fablab-imperia/PesaturaArnie/images/consumo_dati/README.md

I dati fanno riferimento ad un test sul campo svolto nel periodo dal 22 luglio 2019 al 10 settembre 2019

Periodo        |Condizione Funzionamento|Consumo|Costo 
:-------------:|:----------------------:|:-----:|:-------:
1 giorno       | Normale                |14 kB  |~0.002 €
1 giorno       | Allarme                |1.1 MB | ~0.14 €
1 mese         | Normale                |400 kB | 0.05 €
1 anno (stima) | Normale                |5 MB   | 0.60 €

<hr>

<table style="padding: 10px;">
    <tr>
        <th colspan="2">Funzionamento regolare</th>
    </tr>
    <tr>
        <th>Consumo Dati</th>
        <th>Costo</th>
    </tr>
    <tr>
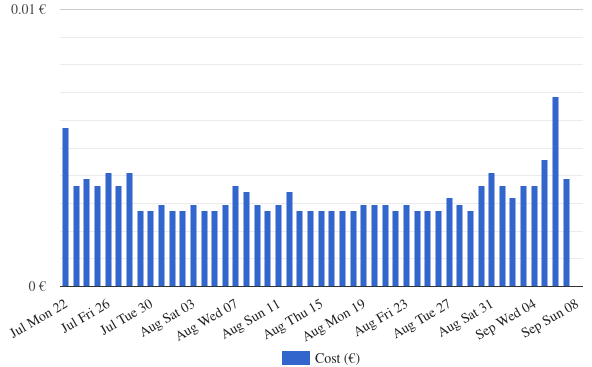
[picture p4: images/consumo_dati/Cost_day_normal.png]
        <td></td>
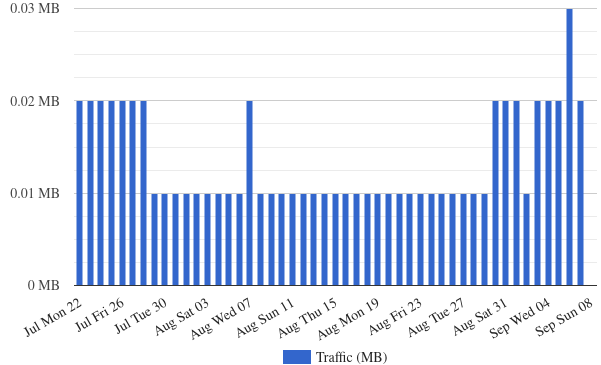
[picture p5: images/consumo_dati/Traffic_day_normal.png]
        <td></td>
    </tr>
    <tr>
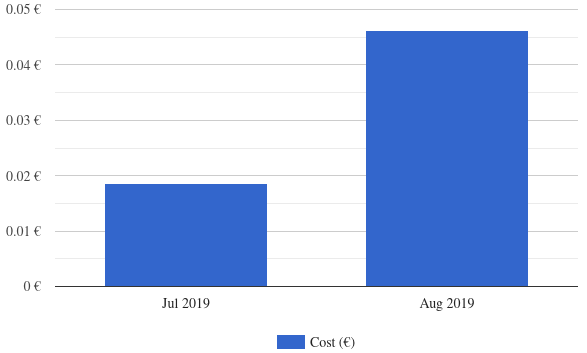
[picture p6: images/consumo_dati/Cost_month_normal.png]
        <td></td>
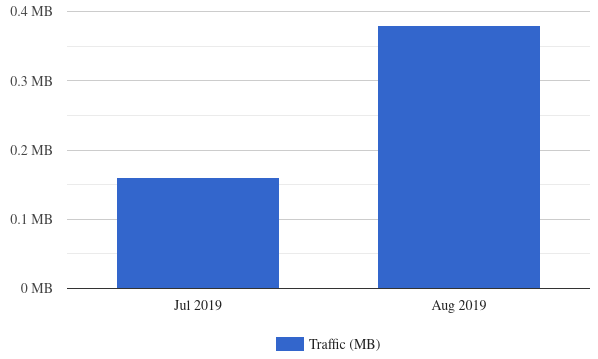
[picture p7: images/consumo_dati/Traffic_month_normal.png]
        <td></td>
    </tr>
</table>

Il sistema ha funzionato in continuo per tutto il mese di Agosto, mentre è stato acceso solo per alcuni giorni a Luglio, per cui il consumo mensile per il mese di luglio non è completo.

<hr>

<table style="padding: 10px;">
    <tr>
        <th colspan="2">Funzionamento in Allarme</th>
    </tr>
    <tr>
        <th>Consumo Dati</th>
        <th>Costo</th>
    </tr>
    <tr>
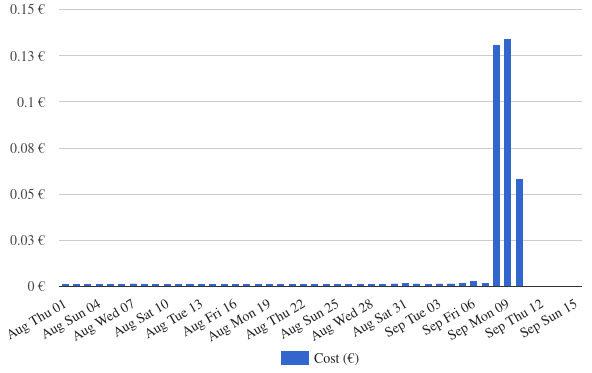
[picture p8: images/consumo_dati/Cost_day_alarm.png]
        <td></td>
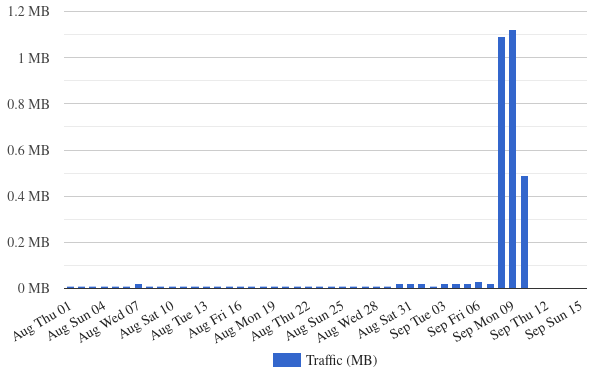
[picture p9: images/consumo_dati/Traffic_day_alarm.png]
        <td></td>
    </tr>
</table>
