fablab-imperia/PesaturaArnie/images/schema_bilancia_api.png

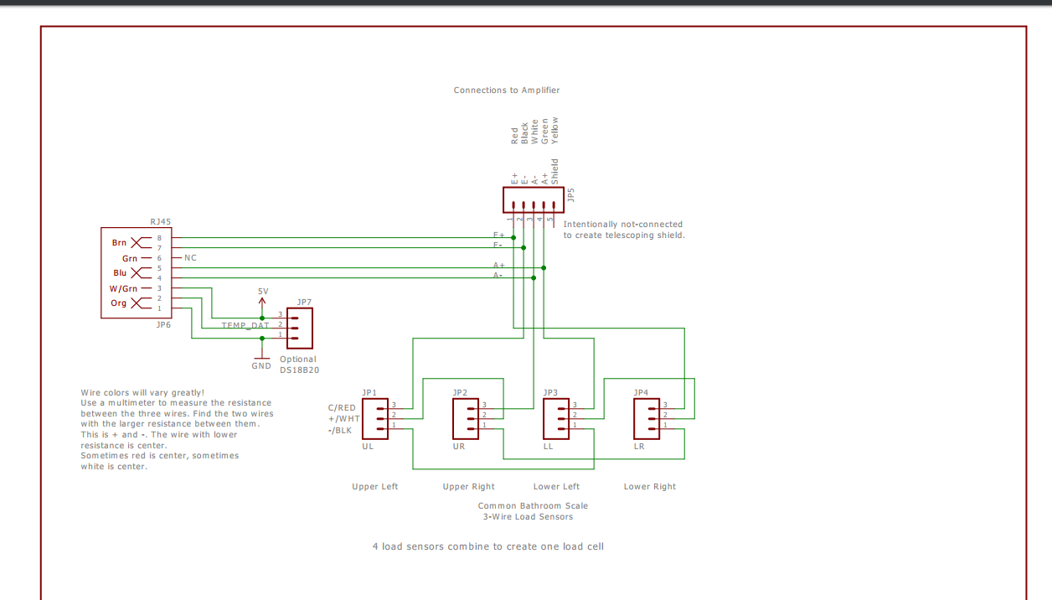
images/schema_bilancia_api.png
