fablab-imperia/PesaturaArnie/(threads)

Thread 1 (2021-04-12):

Richietsa

Tek74, 2021-04-12:
Ciao sono Nicola, non conosco tanto Arduino ne Github....  pero' sto entrando nel mondo
Ora un po' di programmazione l'ho capita ma volevo chiedere un aiuto, ovvero vorrei anch'io fare un sistema per pesature arnia prendendo spunto da Voi. Volevo pero' usare dei pezzi che ho in casa, ovvero arduino uno e su questo mettere la seguente scheda Ttgo t-call v1.3 esp32 (che costa poco) e mettere anche sensore temperatura e umidita' AM2301...
E' fattibile applicare la scheda gsm ttgo su arduino uno? nel caso mi daresti qualche aiuto sulle librerie e programmazione?

Ringrazio e scusa il disturbo

Ciao
Nicola

ssemeria, 2021-04-14:
Ciao Nicola.
Il codice è stato scritto per Arduino MKR, quindi tutta la parte di invio dei dati deve essere modificata usando una libreria con cui la scheda che suggerisci è compatibile (ad esempio https://github.com/vshymanskyy/TinyGSM ). La Ttgo t-call è interessante (avremmo sicuramente usato quella, se lo avessimo saputo). Sarebbe interessante creare una nuova versione del progetto basata sulla scheda che suggerisci in questo momento non siamo però in grado di seguirne gli sviluppi. Ti aggiorniamo in caso avviassimo un progetto nuovo, per il momento puoi pensare di forkare il nostro repository e creare un tuo progetto se vuoi.

Tek74, 2021-04-20:
Grazie veramente... sono neofita dunque necessito di parecchie istruzioni sia su arduino che sull'uso di github.... comunque sto prendendo spunto dai vostri file e per adesso sono riuscito a far leggere il sensore temperatura e umidità Am2301 con la scheda TTGO,  sto collegando anche hx711 e devo testare lo sketch che per ora non mi da errori
Poi dovrò unirli ... è se non sei esperto come me fai veramente fatica.... capisco anche che però sono partito con un progetto un po complesso ma pian piano si fa dai.... mai mollare

Ciao
Nicola

Closed 2021-04-14.

Thread 2 (2021-04-17):

Arnia Tek Pesatura arnia 2.0

Tek74, 2021-04-17:
Pesatura Arnie

Scopo di questo progetto è la realizzazione di un semplice sistema per la pesatura e il monitoraggio di Arnie. Il sistema controlla il peso di un'arnia mediante bilancia a celle di carico, umidità e temperatura e consente un monitoraggio continuo appoggiandosi ad una piattaforma Web e avvisa mediante notifica in caso di anomalia (peso troppo basso, batteria al minimo). Viene usata una nuova scheda TTGO t-call v1.4 e ulteriore sensore di temperatura tipo AM2301.

federicobriata, 2021-05-25:
ciao @Tek74 , vedo che segui il nostro fork di hiveeyes
https://github.com/federicobriata/Bilancia-per-alveari
che praticamente fa quello che ti serve.. che idea avevi in mente per Arnia Tek?

ssemeria, 2021-05-26:
Chiedo scusa, ma questo non è un forum di discussione. Se non avete segnalazioni relative a questo repository Github, vi chiedo la cortesia di continuare la conversazione tra di voi utilizzando altri canali più appropriati.

Tek74, 2021-05-26:
Si scusa ssemeria non conosco github...non capisco come si usa... se riuscite cancellate pure la mia parte... Grazie

ssemeria, 2021-05-26:
Nessun problema. L'idea è che scrivi qui se vuoi segnalare problemi nel codice del nostro progetto su cui vuoi lavorare o vuoi che noi lavoriamo. Questo progetto è un hobby quindi ci dedichiamo davvero poco tempo.

federicobriata, 2021-05-26:
@ssemeria pure per me questo è un hobby e per aiutare alcuni amici nel Acquese e Genovese, io manco ho più le arnie da quando è mancato mio nonno..
Ad ogni modo per quello che ne sapevo voi due potevate anche conoscervi e questo ticket poteva sembrare una richiesta di nuova features e la mia una offerta di collaborazione, fino ai tuo commento non mi sentivo OT o fuori posto visto che il tema mi pare pressappoco lo stesso.
Se hai anche un link su forum dove poter continuare questa discussione ben venga, io non ne conosco. Grazie

@Tek74 la mia email la trovi sulle commit del mio progetto, il resto su Google. ti lascio anche il telegram: @fedegroovie
Ciao

Closed 2021-05-26.
