fablab-imperia/PesaturaArnie/Batteria.ino

float livello_batteria() {                                                            // Controlla lo stato della batteria...
  float min_batteria = 3.6;                                                           // La tensione massima della batteria
  float max_batteria = 4.2;                                                           // La tensione minima della batteria

  tens = 0;                                                                           // Azzero la variabile che userò per mediare 10 valori

  for (int i = 0; i < 10; i++) {
    tens += analogRead(ADC_BATTERY) * (4.3 / 1023.0);                                 // Leggo la tensione della batteria per 10 volte
    delay(2000);                                                                      // Attendo 2 secondi tra due letture consecutive
  }

  tens /= 10;                                                                         // Medio i 10 valori letti

  return (100 * (tens - max_batteria) / (max_batteria - min_batteria) + 100);         // Ritorna la percentuale della batteria, considerando
}                                                                                     // 0% min_batteria e 100% max_batteria
