fablab-imperia/PesaturaArnie/(commit log)

2018-11-25 Ultima versione con commenti di debug a iosa
2019-01-07 Sono Luca aggiunta SD e altro vedi desacrizione
    aggiunto un init_GSM alla funzione Pubblica() dove si controlla se mqtt è connesso e se non connesso prima si riconnette il modem e poi si connette il broker..
    faccio un checkGPS() all'inizione del loop che vale per tutto il ciclo cosi da snellire il codice. lascio gli altri commentati con un "!" davanti per riconoscerli. rimane il primo check_GPS per il setup...
    Aggiunto init_GSM() prima di cercare la posizioneGSM in caso di perdita del modem come per mqtt
    [Fuzioni_secondarie.ino, GPS_LOC.ino, GSM.ino, MQTT.ino, PesaturaArnie.ino]
2019-12-04 Versione con Bot Telegram
    Aggiorno all'ultima versione prima di perderla definitivamente.
    Rispetto alla precedente praticamente ho solo aggiunto il bot su telegram che manda periodicamente i dati di peso e batteria e gli allarmi.
2021-03-17 :memo: Circuit schematic image
2021-03-17 :memo: Add schematic in readme
2021-03-17 :memo: Change svg schematic to png (to avoid visualizarion problems)
2021-03-17 :memo: Change link to schematic file (svg to png)
2021-03-17 :memo: Fix board specs relative link
2021-03-18 :memo: Board installation and libraries
2021-03-18 :memo: Board version to fix library retro-compatibility
2021-03-21 :memo: Remove duplicate (schematic)
2021-03-30 :memo: Add battery and weight test data (csv)
    [batteria_peso.csv]
